jnavudu2/ECE445Battlebots/notebooks/avikv2/controller_revB_pcba.png

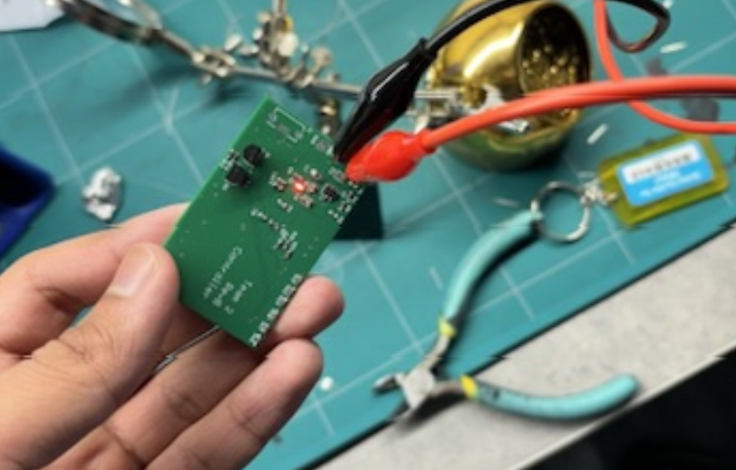
notebooks/avikv2/controller_revB_pcba.png
