jnavudu2/ECE445Battlebots/notebooks/avikv2/i2c_mux.png

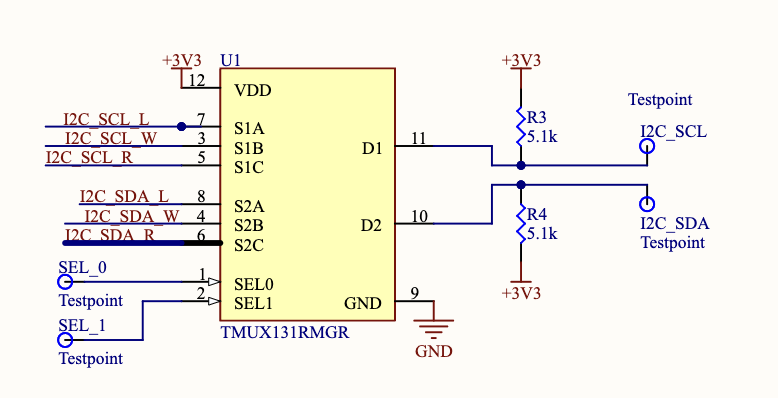
notebooks/avikv2/i2c_mux.png
