jnavudu2/ECE445Battlebots/notebooks/avikv2/LMR50410Y3FQDBVRQ1.png

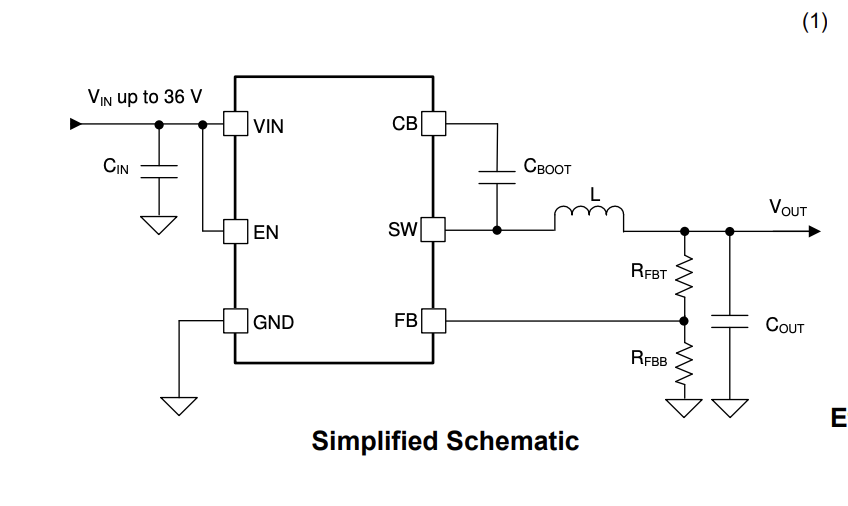
notebooks/avikv2/LMR50410Y3FQDBVRQ1.png
