jnavudu2/ECE445Battlebots/notebooks/avikv2/revB_controller.png

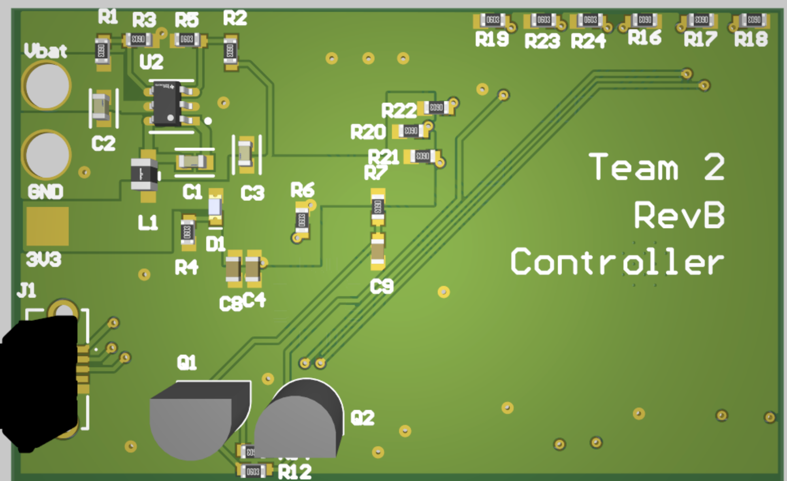
notebooks/avikv2/revB_controller.png
