jnavudu2/ECE445Battlebots/notebooks/avikv2/revB_driver.png

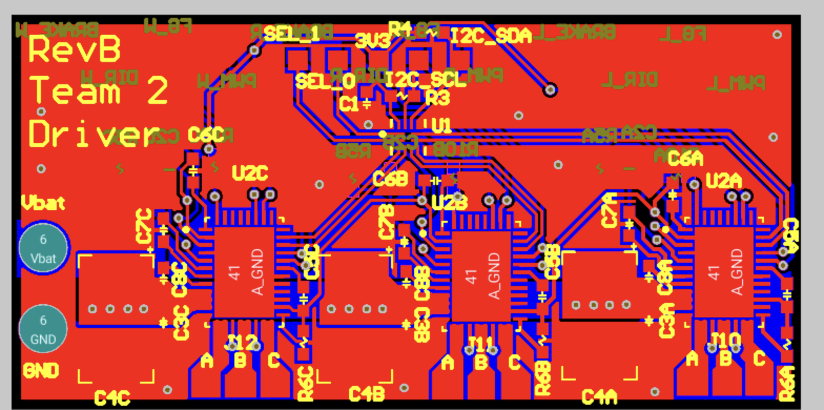
notebooks/avikv2/revB_driver.png
