jnavudu2/ECE445Battlebots/notebooks/avikv2/uart_bridge.png

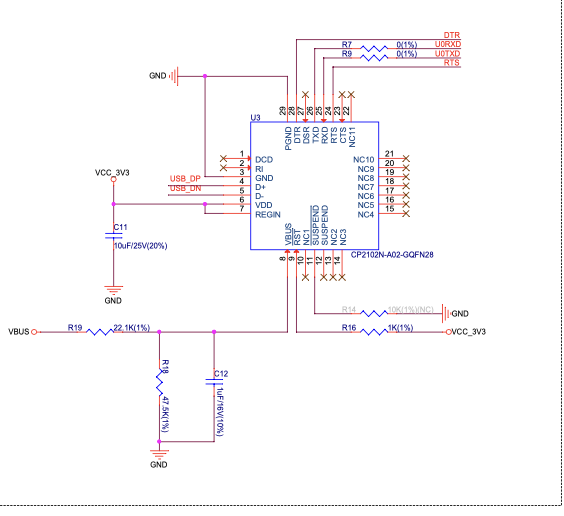
notebooks/avikv2/uart_bridge.png
