jnavudu2/ECE445Battlebots/boards/revB/Drivesystem/ECE445 DriveSystem BOM.xlsx

Name | Description | Designator | Footprint | LCSC Part Number
CAP-0603 | 1 uF, 25V | C1 | 0603 | C85862
CMP-001-00006-4 | 1 uF, +/- 10%, 25 V | C2A | 1206 | C28322
CMP-001-00006-4 | 1 uF, +/- 10%, 25 V | C2B | 1206 | C28322
CMP-001-00006-4 | 1 uF, +/- 10%, 25 V | C2C | 1206 | C28322
CAP-0603 | 0.1 uF, 16V ceramic, X5R or X7R | C3A | 0603 | C66501
CAP-0603 | 0.1 uF, 16V ceramic, X5R or X7R | C3B | 0603 | C66501
CAP-0603 | 0.1 uF, 16V ceramic, X5R or X7R | C3C | 0603 | C66501
CMP-001-00025-5 | Aluminum Electrolytic Capacitor, 10 uF, +/- 20%, 50 V, -40 to 85 degC, 2-Pin THD, RoHS, Bulk | C4A | EEF-CX1E330R-Footprint-1 | C2997488
CMP-001-00025-5 | Aluminum Electrolytic Capacitor, 10 uF, +/- 20%, 50 V, -40 to 85 degC, 2-Pin THD, RoHS, Bulk | C4B | EEF-CX1E330R-Footprint-1 | C2997488
CMP-001-00025-5 | Aluminum Electrolytic Capacitor, 10 uF, +/- 20%, 50 V, -40 to 85 degC, 2-Pin THD, RoHS, Bulk | C4C | EEF-CX1E330R-Footprint-1 | C2997488
CAP-0603 | 1 uF, 16V ceramic, X5R or X7R | C5A | 0603 | C106248
CAP-0603 | 1 uF, 16V ceramic, X5R or X7R | C5B | 0603 | C106248
CAP-0603 | 1 uF, 16V ceramic, X5R or X7R | C5C | 0603 | C106248
CAP-0603 | 1 uF, 16V ceramic, X5R or X7R | C6A | 0603 | C106248
CAP-0603 | 1 uF, 16V ceramic, X5R or X7R | C6B | 0603 | C106248
CAP-0603 | 1 uF, 16V ceramic, X5R or X7R | C6C | 0603 | C106248
CAP-0603 | 47 nF, 16V ceramic, X5R or X7R | C7A | 0603 | C115058
CAP-0603 | 47 nF, 16V ceramic, X5R or X7R | C7B | 0603 | C115058
CAP-0603 | 47 nF, 16V ceramic, X5R or X7R | C7C | 0603 | C115058
CAP-0603 | 1 uF, 16V ceramic, X5R or X7R | C8A | 0603 | C106248
CAP-0603 | 1 uF, 16V ceramic, X5R or X7R | C8B | 0603 | C106248
CAP-0603 | 1 uF, 16V ceramic, X5R or X7R | C8C | 0603 | C106248
RES-0603 | 5.1k | R3 | 0603 | C23186
RES-0603 | 5.1k | R4 | 0603 | C23186
RES-0603 | 22 | R5A | 0603 | C23345
RES-0603 | 22 | R5B | 0603 | C23345
RES-0603 | 22 | R5C | 0603 | C23345
RES-0603 | 10k | R6A | 0603 | C15401
RES-0603 | 10k | R6B | 0603 | C15401
RES-0603 | 10k | R6C | 0603 | C15401
RES-0603 | 5.1k | R10A | 0603 | C23186
RES-0603 | 5.1k | R10B | 0603 | C23186
RES-0603 | 5.1k | R10C | 0603 | C23186
TMUX131RMGR | Texas Instruments TMUX131RMGR Low capacitance, 3.6-V, 3: 1, 2-channel, powered-off protected switch with 1.8-V logic 12-WQFN -40 to 85 | U1 | WQFN | C22396276
MCF8316A1VRGFR | Texas Instruments MCF8316A1VRGFR BLDC Motor Driver | U2A | VFQFN | C3681167
MCF8316A1VRGFR | Texas Instruments MCF8316A1VRGFR BLDC Motor Driver | U2B | VFQFN | C3681167
MCF8316A1VRGFR | Texas Instruments MCF8316A1VRGFR BLDC Motor Driver | U2C | VFQFN | C3681167
