jnavudu2/ECE445Battlebots/notebooks/jnavudu2/test.md

## Table of Contents
- [Introduction](#introduction)
- [Getting Started](#getting-started)
- [Advanced Topics](#advanced-topics)
  - [Topic One](#topic-one)
  - [Topic Two](#topic-two)
- [Conclusion](#conclusion)

## Introduction
Content for the introduction section.

## Getting Started
Content for the getting started section.

## Advanced Topics
Content for the advanced topics section.

### Topic One
Content for topic one.

### Topic Two
Content for topic two.

## Conclusion
Content for the conclusion section.
