jnavudu2/ECE445Battlebots/notebooks/avikv2/3v3_test.png

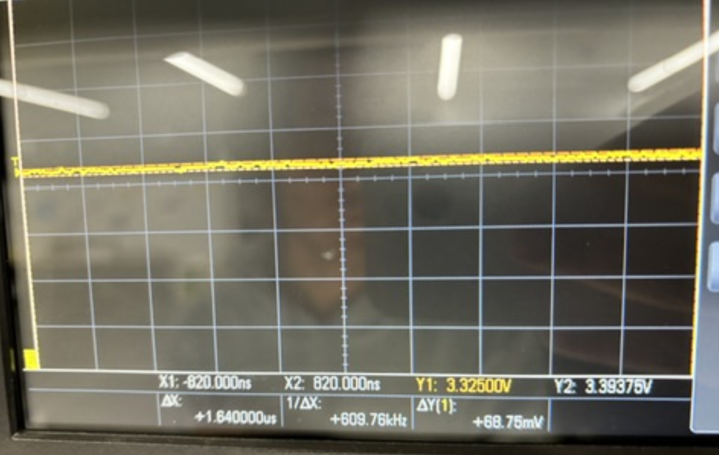
notebooks/avikv2/3v3_test.png
