jnavudu2/ECE445Battlebots/notebooks/avikv2/pwm_test_results.png

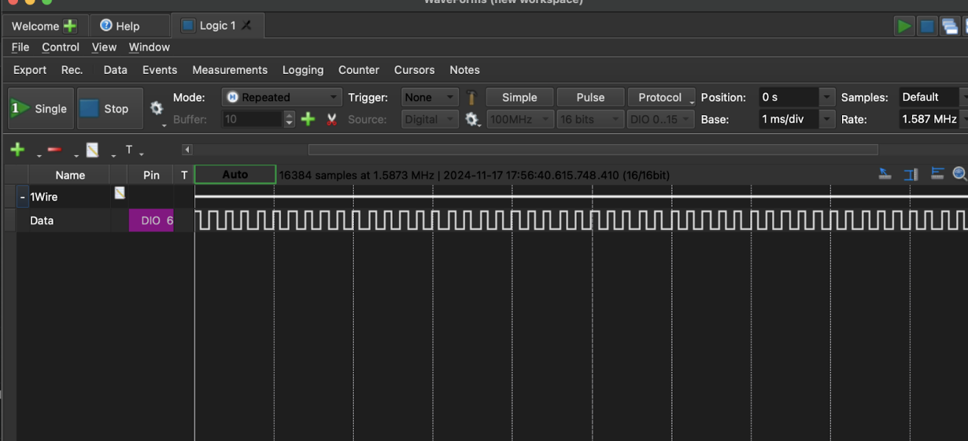
notebooks/avikv2/pwm_test_results.png
