jnavudu2/ECE445Battlebots/notebooks/avikv2/SW_test_setup.png

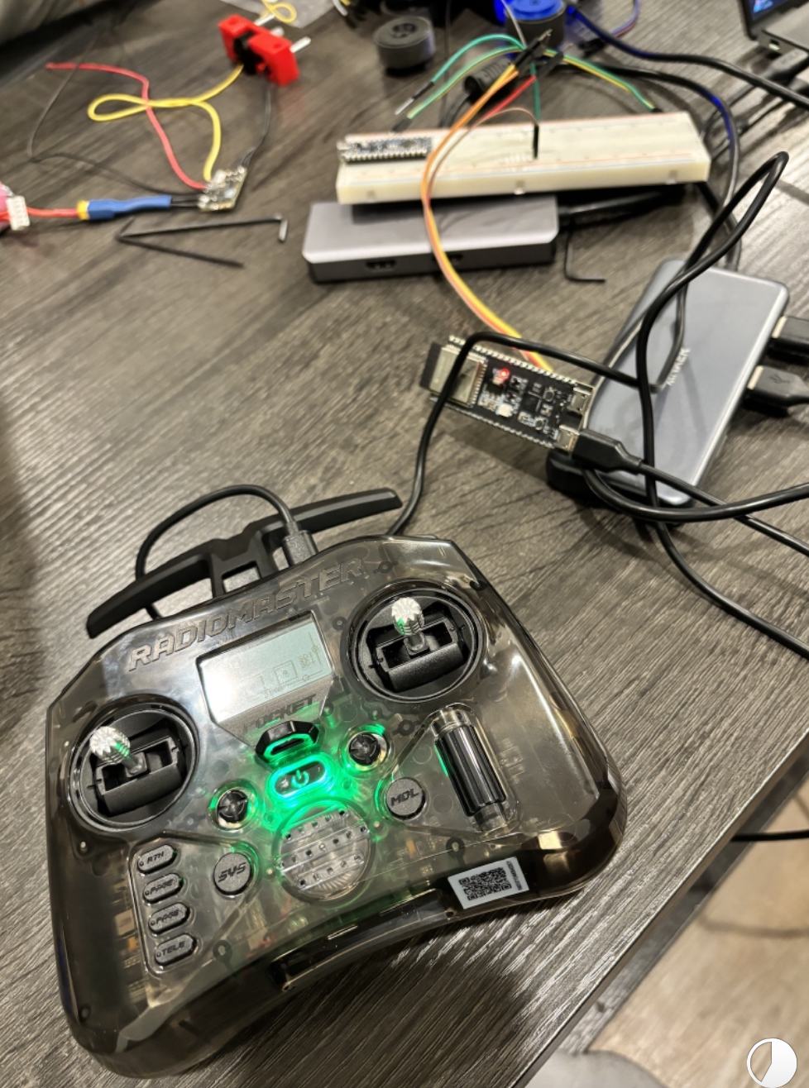
notebooks/avikv2/SW_test_setup.png
