jnavudu2/ECE445Battlebots/(list of files, drawings)

Other design files:
boards/revA/Controller_BattleBot.PcbDoc
boards/revA/Drive_Motors.SchDoc
boards/revA/DriveSystem_RevA.PcbDoc
boards/revA/Microcontroller.SchDoc
boards/revA/Power_Schematics.SchDoc
boards/revA/Weapon_Motor.SchDoc
boards/revA/Weapon_System_RevA.PcbDoc
