jnavudu2/ECE445Battlebots/code/battle_bot/main/includes/mcf8316a.h

#ifndef MCF8316A_H
#define MCF8316A_H

#include <string.h>
#include <stdio.h>
#include "sdkconfig.h"
#include "esp_types.h"
#include "esp_log.h"
#include "esp_check.h"
#include "esp_check.h"
#include "esp_adc/adc_oneshot.h"

#define MCF8316A_I2C_SLAVE_ADDR           0x01

typedef struct {
    uint8_t mux_sel;
    uint8_t brake_pin;
    uint8_t direction_pin;
    adc_oneshot_unit_handle_t adc_feedback;
    uint8_t speed_pin;
} mcf8316a_pinout_t;

typedef struct{
    uint32_t speed;             // 0-100 as a percentage
    uint32_t brake_status;      // 0 - no brake, 1 - brake
    uint32_t direction;         // 1 - forward, 0 direction
    uint32_t feedback_speed;    // adc read of speed
} mcf8316a_t;

typedef enum {
    drive_motor_l,
    drive_motor_r,
    weapon_motor,
    motor_count
} e_motor;

// initialize array of structs with motor configs
esp_err_t mcf8316a_init();

// configure MCF8316A over I2C (run at initialization)
esp_err_t mcf8316a_configure(i2c_master_dev_handle_t* dev_handle, e_motor motor_index);

// control the speed, braking, and direction of the motor
esp_err_t mcf8316a_control(e_motor motor_index, uint32_t speed, uint32_t brake, uint32_t dir);

// read the feedback speed and fault status of the motor
esp_err_t mcf8316a_get_status(e_motor motor_index);

#endif /* MCF8316A_H */
