jnavudu2/ECE445Battlebots/(commit log)

2024-10-31 initial code and board
    [Controller_BattleBot.PcbDoc, DriveSystem_RevA.PcbDoc, Drive_Motors.SchDoc, Microcontroller.SchDoc, Power_Schematics.SchDoc, Weapon_Motor.SchDoc, Weapon_System_RevA.PcbDoc]
2024-11-07 worked on motor driver, just need to write mcpwm library
2024-11-08 all drivers done, need to write kconfig file
2024-11-15 adding bluetooth code; BOM
    [ECE445 DriveSystem BOM.xlsx, picknplacedrivesystem.csv]
2024-11-15 better board structuring
    [ECE445 DriveSystem BOM.xlsx, picknplacedrivesystem.csv]
2024-12-04 simulator and pc software
    [bluetooth_connection.csv, bluetooth_delay.csv]
