jnavudu2/ECE445Battlebots/notebooks/jnavudu2/builtv2.JPG

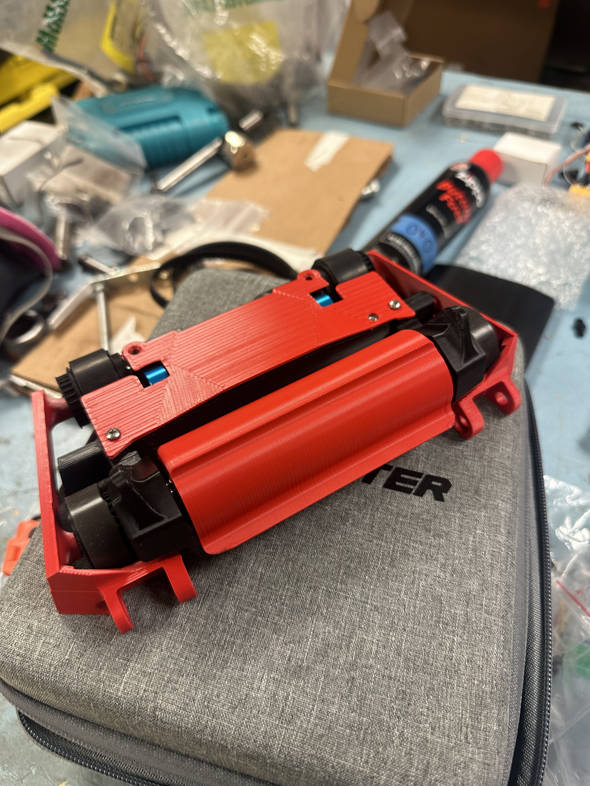
[picture p7: notebooks/jnavudu2/builtv2.JPG]
notebooks/jnavudu2/builtv2.JPG
